jhrvo0/ChickenLittle/docs/design/redesign_2026-11/prototype.html

MOTIONPET

Dispositivo5 Tema PalcoF Simular

1

# —

—

1. 1Piloto
2. 2Mira
3. 3Força
4. 4Voo
5. 5Resultado

PINTINHO · nível 3120 XP

$42 moedas

Que dia bom!

Ovo Pintinho Galo cyber

## Piu-piu

Feliz

Saciedade—

Felicidade—

Energia—

Saúde—

## Cuidar

Alimentarou cartão no IR Carinhoou mão perto Brincar Descansar Cuidar da saúde

Salvar Carregar

RECORDE—

Recorde —

$42 moedas

## ATÉ ONDE O PIU-PIU VOA?

1. 1mãomira o ângulo
2. 2cartãosegura para dar força
3. 3solta na faixa verde e voa!

Aproxime e afaste o cartão do IR para jogar

Piloto de hoje

## PIU-PIU

Pintinho · nível 3Energia 85% · pronto

Passe o cartão de novo para ir à rampa

Ângulo

—

mão a —

pertosobe70°

longedesce20°

Pronto? Segure o cartão no IR

Força

—

FAIXA PERFEITA

050%100%

tire o cartão para lançar

Distância

0,0 m

altura 0,0 m

NOVO RECORDE!

Distância do voo

—

—

—pontos

—moedas

—XP

—quiques

Passe o cartão para jogar de novo

## Loja

$42

Sem a placa? Use o teclado

JogarEnter Carregar forçaEspaço Ângulo +↑ Ângulo −↓ VoltarB

Ativar somM

Nota de agora

—

—

♪♫

## Som

desligado

Ativar somM

O navegador só libera o áudio depois de um clique.

Volume 35%

## Como tocar

- pertonotas graves
- longenotas agudas
- cartãosilêncio: não

Faixa das notas: de 8 a 48 cm do sensor.

01 · Olá, mundo

## —

—

MOTIONPET

1 / 8

## Slide

1 / 8

Anterior Próximo

Pronto.

## Gestos

- pertopróximo
- longeanterior
- cartãopróximo

Espere 1 segundo entre um gesto e outro. Teclado: ← →

## Conexão

—

Porta —

Estado —

Última leitura —

Quadros recebidos —

Pacotes RX / TX —

## Ultrassom

HC-SR04 · TRIG GPIO5 · ECHO GPIO34

Distância —

Leitura válida —

## Infravermelho e gesto

TCRT5000 · GPIO35

Cartão no IR —

Gesto do classificador —

—

Os modos usam regras de distância e as bordas do IR; o classificador aparece aqui só para consulta.

## LCD lógico 20×4

substituído pela tela

## Aconteceu por aqui

## Atalhos

1a 5 troca de telaFModo Palco (tela cheia) · Esc saiTtema claro / escuroEnterPet Launch: confirmar / lançarEspaçoPet Launch: carregar força↑↓ ângulo · B voltar←→ slidesMMúsica: ligar / desligar o som

Mão

—cm

distância da mão

O que a mão faz aquiHC-SR04 · TRIG GPIO5 · ECHO GPIO34

0102030405060+

Sem placa: conecte ao lado para ver a mão aqui

Cartão no IR

—

—

TCRT5000 · GPIO35

Desconectado

Escolha a porta e conecte

Conectar

Desconectar

1234 SairEsc

## Simulação (só no protótipo)

Passe o mouse na régua para mover a mão. Segure a lâmpada do IR ou a tecla C para o cartão.

Conexão Fase do Launch Estágio do pet Humor Mão e cartão automáticos
