jhrvo0/ChickenLittle/applications/README.md

# Aplicações

Este é um ponto de entrada para a estrutura indicada na especificação acadêmica. As fontes continuam nos diretórios existentes para preservar imports, scripts e testes:

- [Aplicação local, frontend e backend](../terminal/)
- [Machine learning e API de inferência](../ml/)
- [Simulador](../simulator/)
- [Infraestrutura de experimentos](../ops/)

Consulte o [README principal](../README.md) e o [índice de documentação](../docs/README.md). A aceitação de índices como organização por diretório deve ser confirmada com os professores.
