jhrvo0/ChickenLittle/docs/academico/checkpoint_2026-11-12/figuras/figura-1-circuito-atual.png

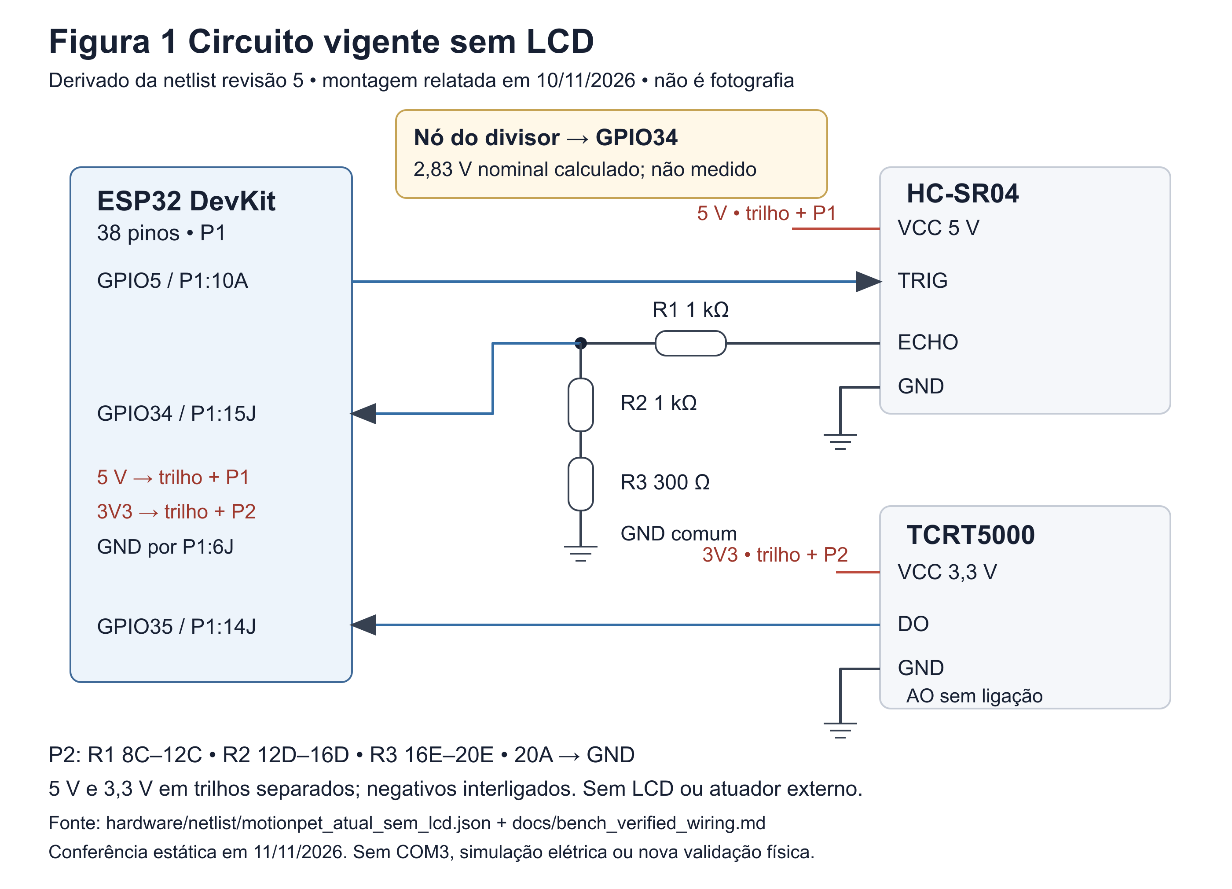
docs/academico/checkpoint_2026-11-12/figuras/figura-1-circuito-atual.png
