jhrvo0/ChickenLittle/docs/academico/checkpoint_2026-11-12/figuras/figura-3-arquitetura.png

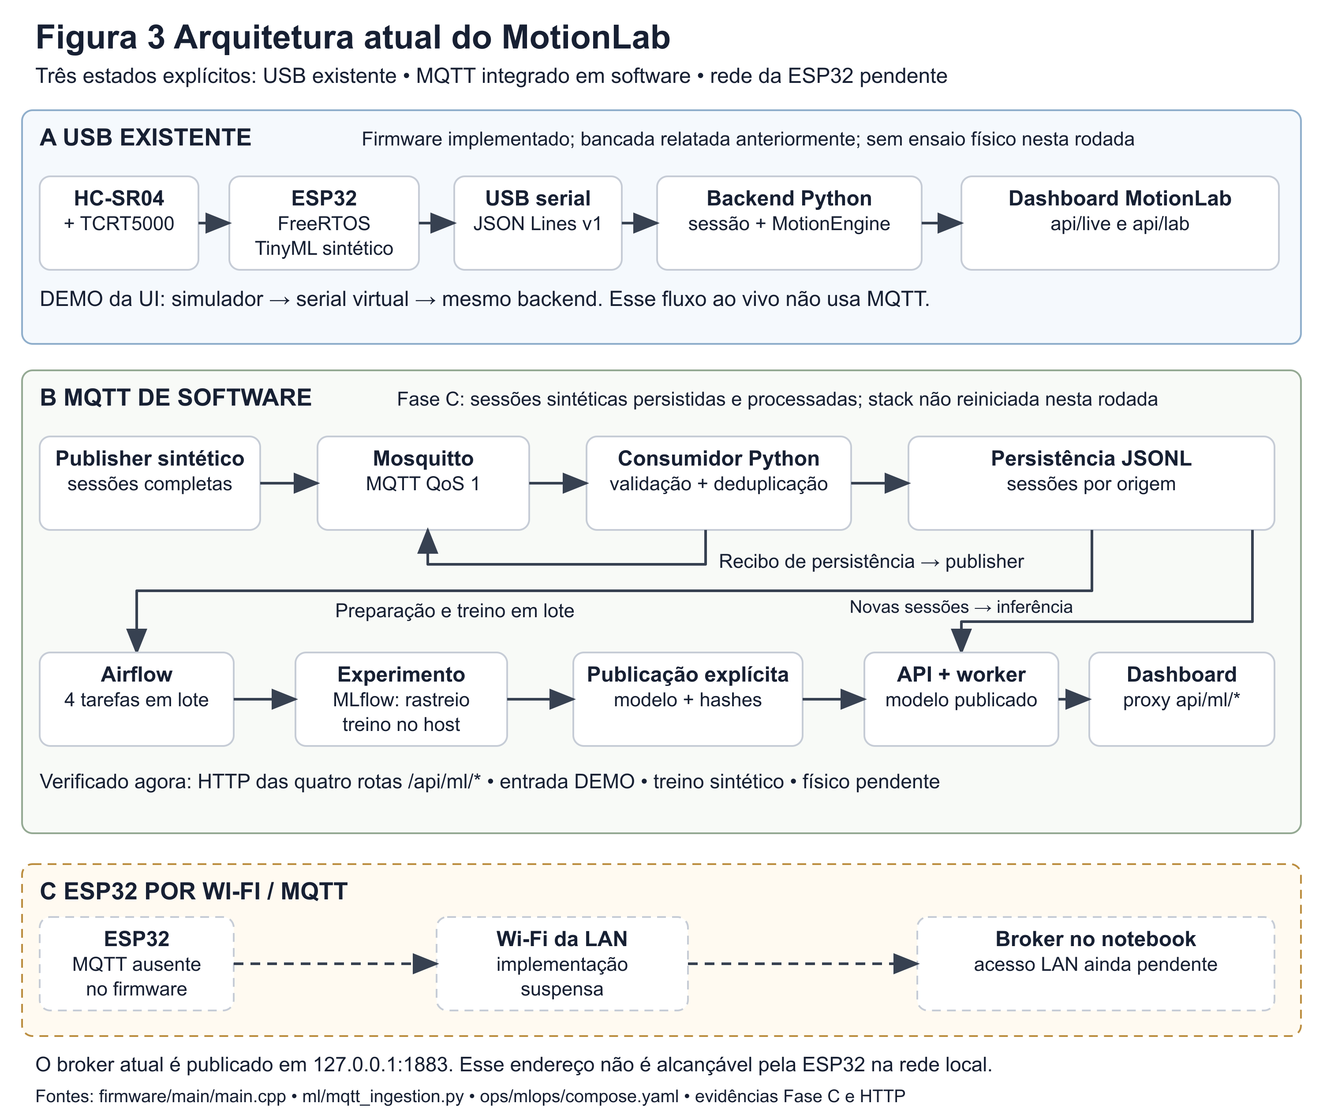
docs/academico/checkpoint_2026-11-12/figuras/figura-3-arquitetura.png
