jhrvo0/ChickenLittle/docs/capturas-motionlab/01-inicio-demo.jpg

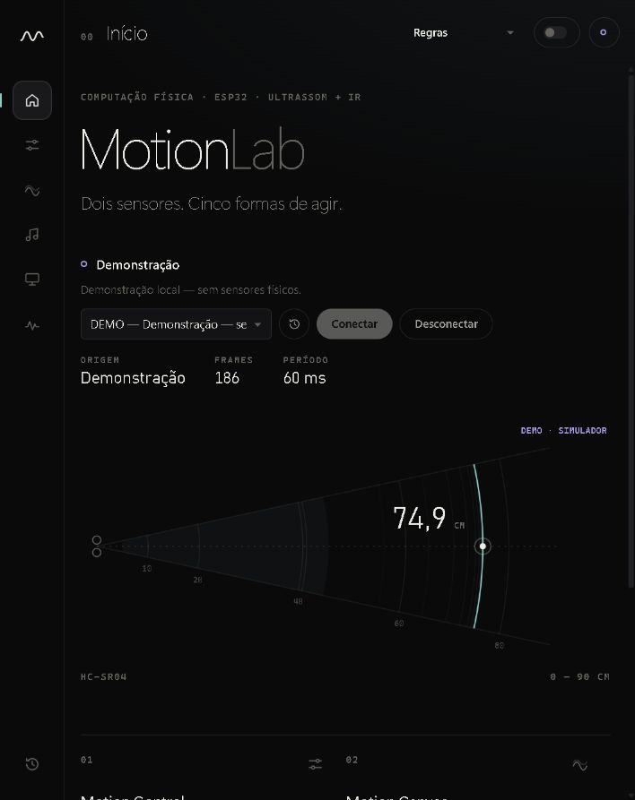
docs/capturas-motionlab/01-inicio-demo.jpg
