jhrvo0/ChickenLittle/docs/fotos-bancada/detalhe-divisor.jpg

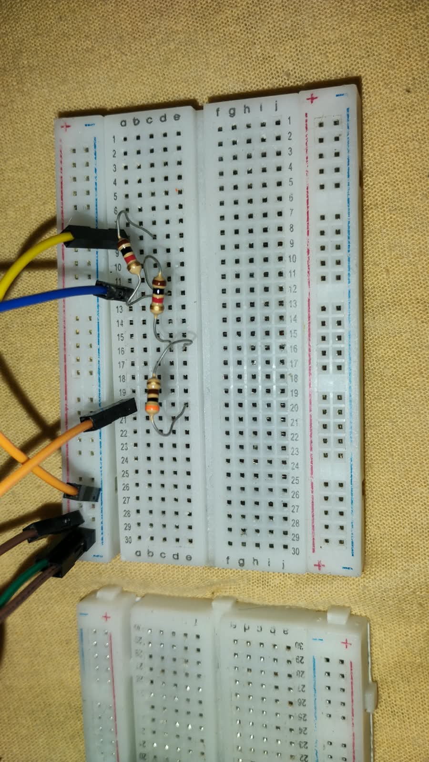
docs/fotos-bancada/detalhe-divisor.jpg
