jhrvo0/ChickenLittle/docs/fotos-bancada/detalhe-esp32.jpg

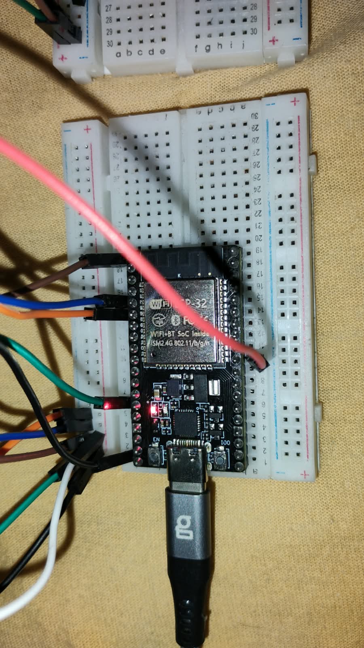
docs/fotos-bancada/detalhe-esp32.jpg
