jhrvo0/ChickenLittle/hardware/out/esquematico_estagioA.png

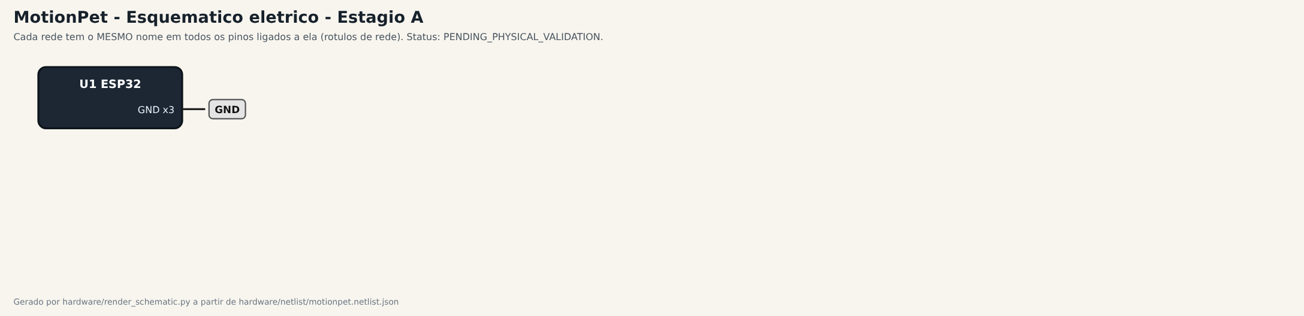
hardware/out/esquematico_estagioA.png
