jhrvo0/ChickenLittle/hardware/out/esquematico_estagioB.png

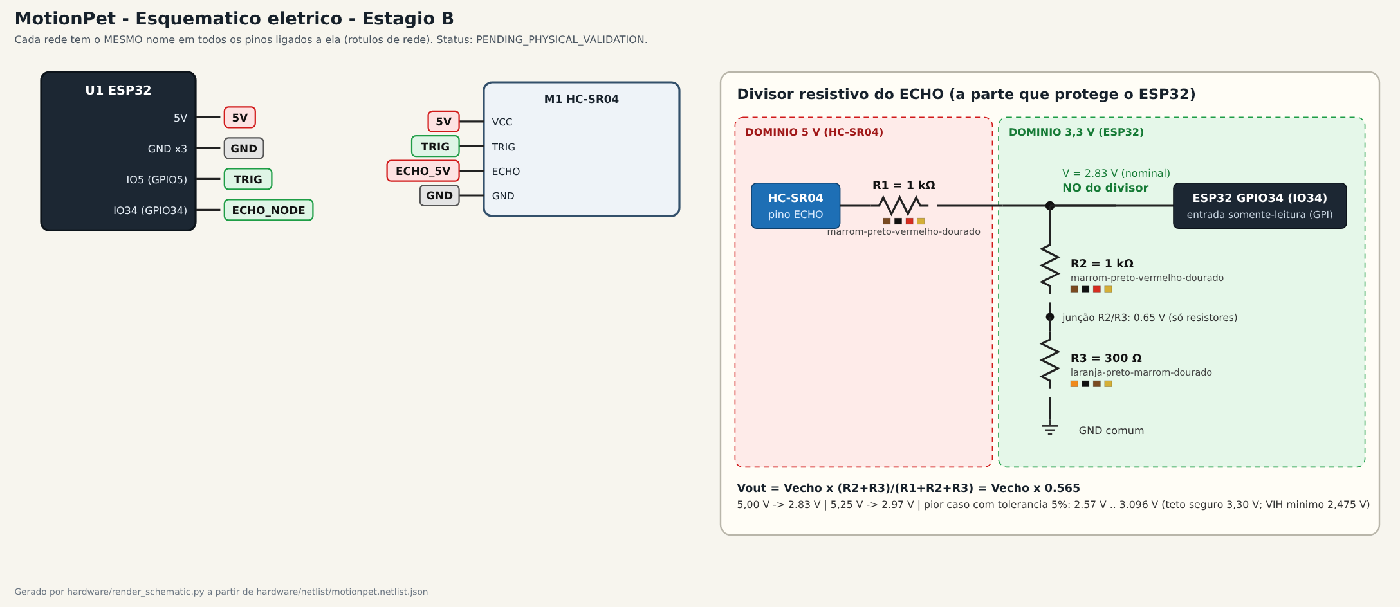
hardware/out/esquematico_estagioB.png
