jhrvo0/ChickenLittle/hardware/out/esquematico_estagioC.png

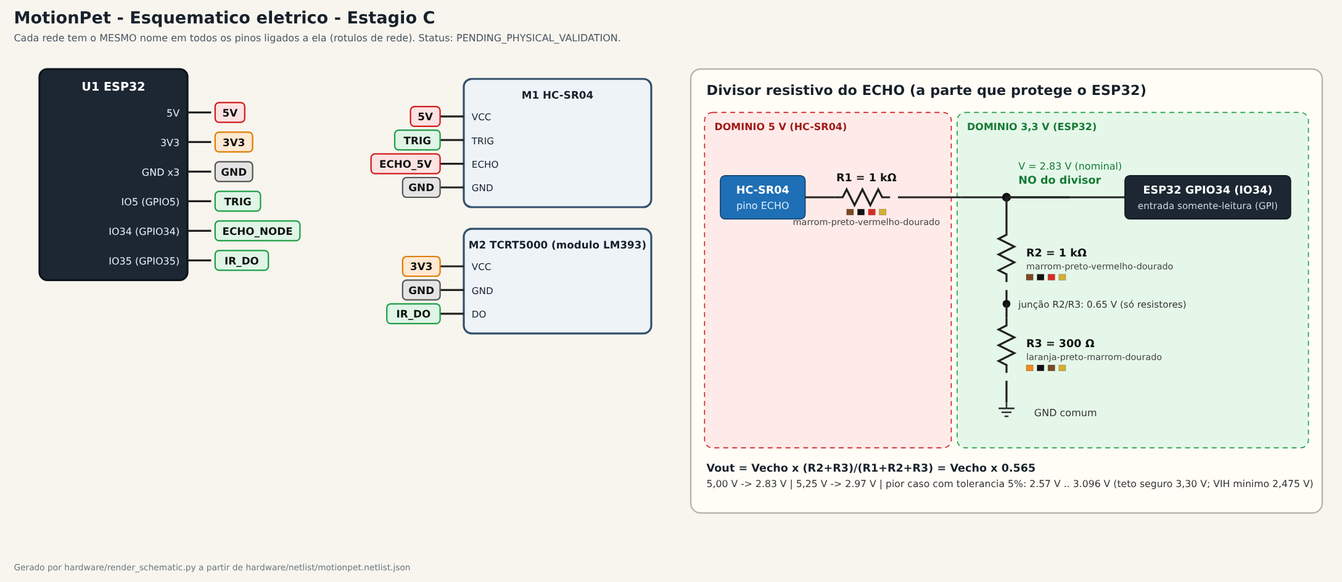
hardware/out/esquematico_estagioC.png
