jhrvo0/ChickenLittle/hardware/out/esquematico_estagioD.png

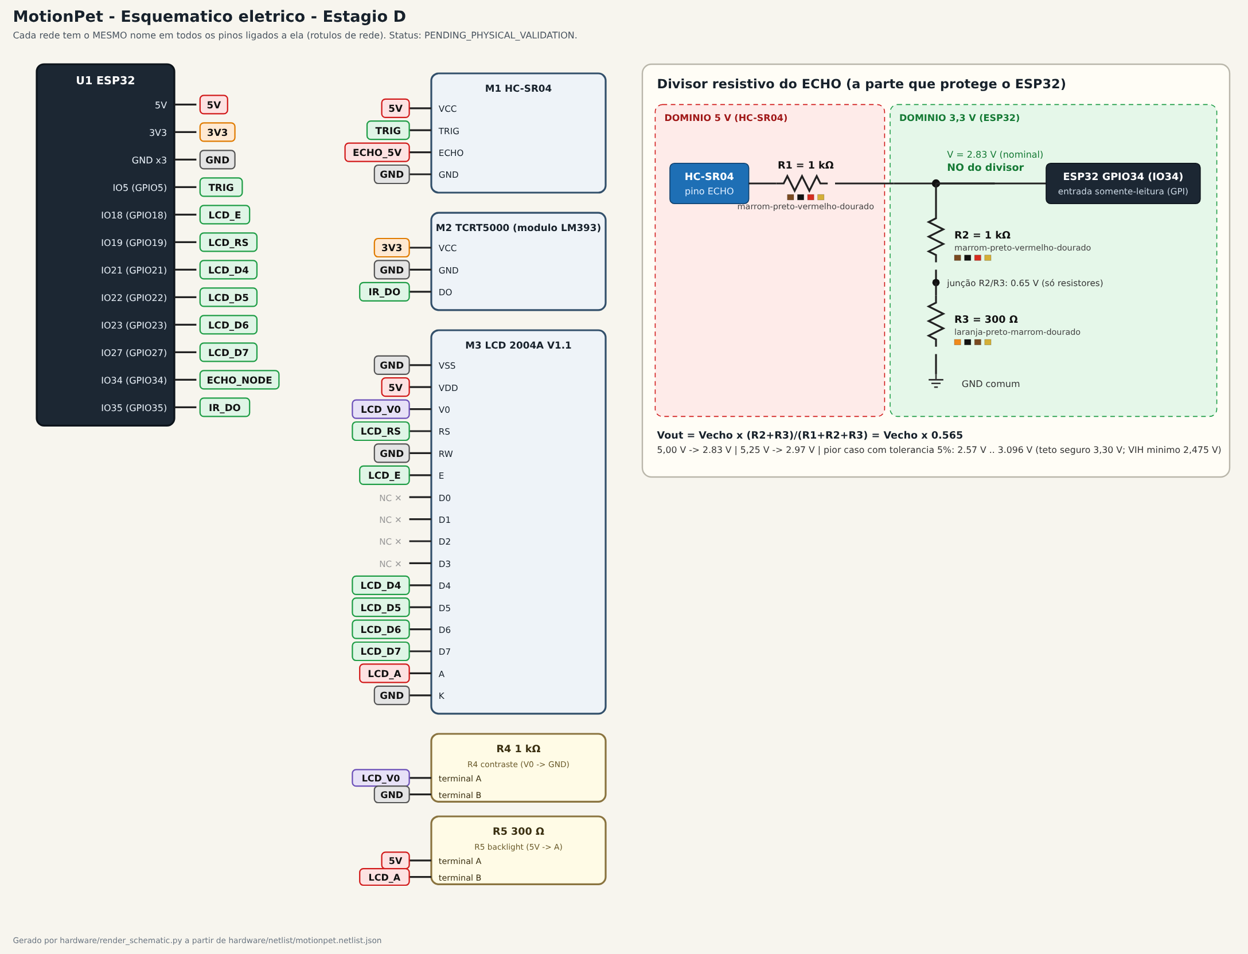
hardware/out/esquematico_estagioD.png
