jhrvo0/ChickenLittle/hardware/out/protoboard_estagioA.png

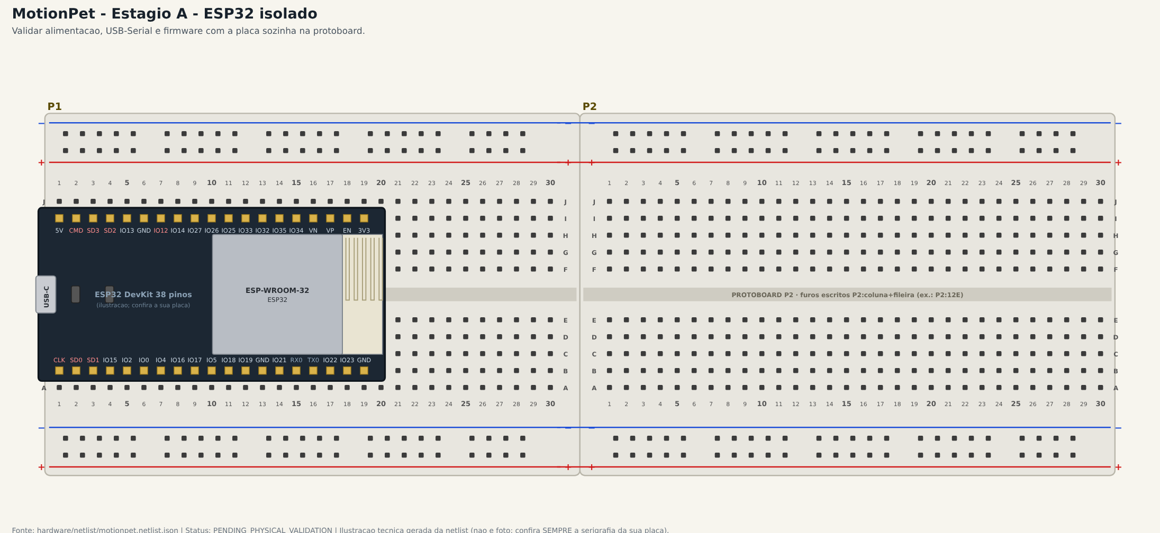
hardware/out/protoboard_estagioA.png
