jhrvo0/ChickenLittle/hardware/out/protoboard_estagioB.png

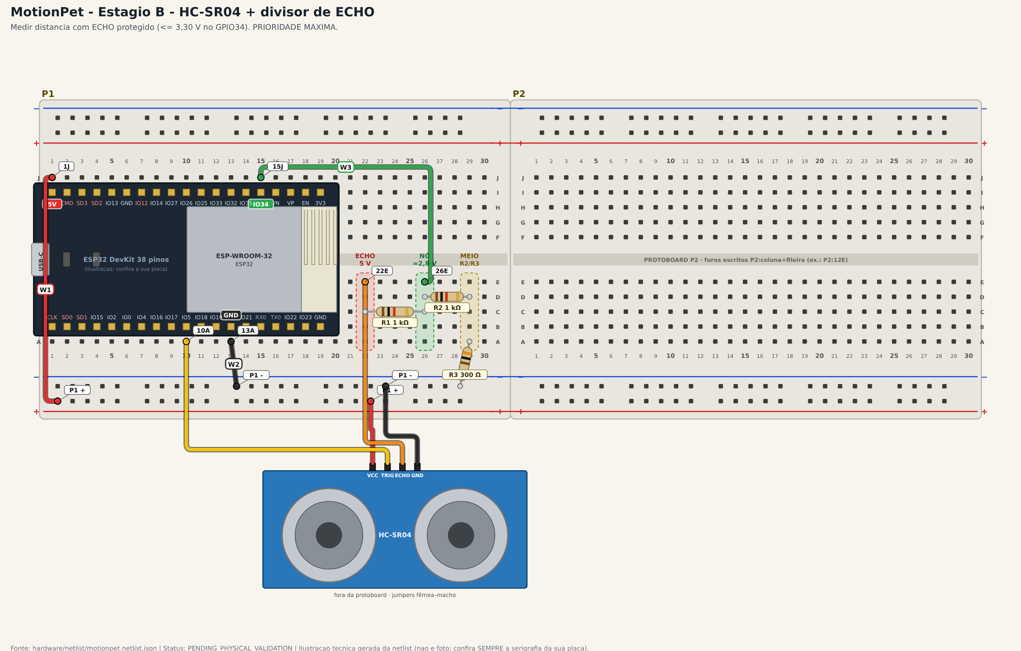
hardware/out/protoboard_estagioB.png
