jhrvo0/ChickenLittle/hardware/out/protoboard_estagioB_passo5_ensaio_divisor.png

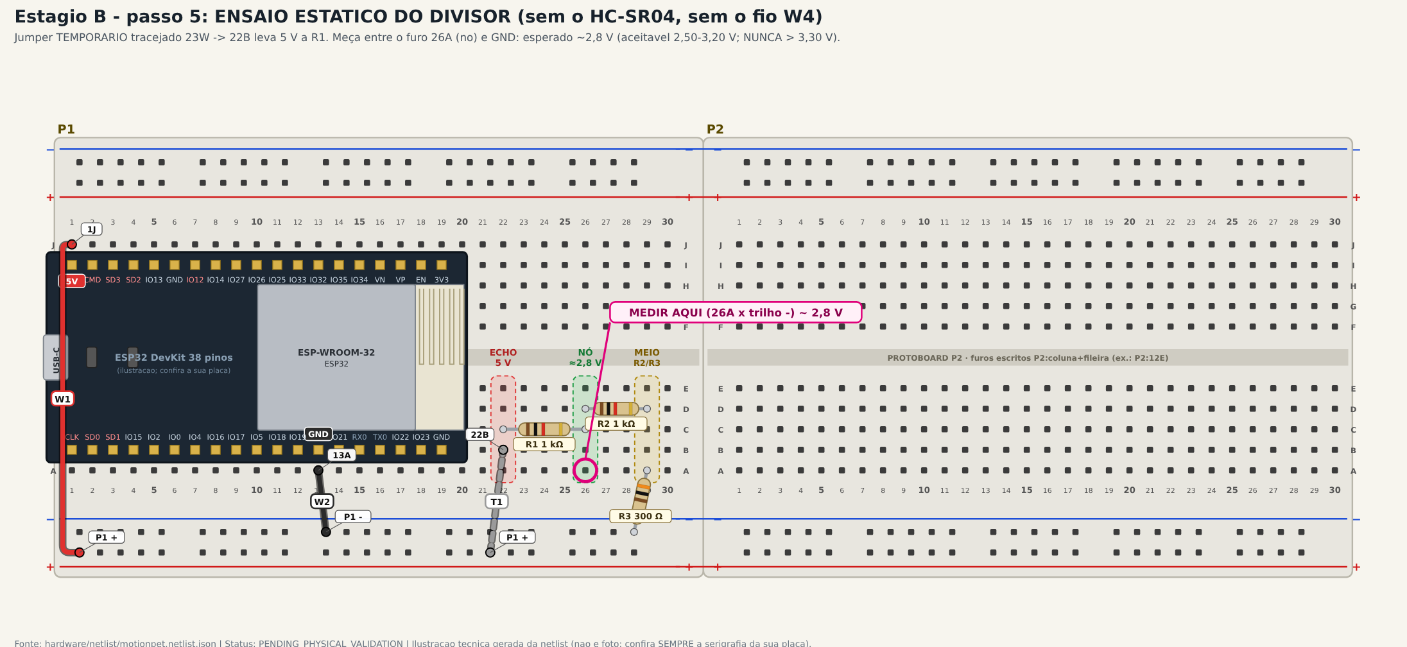
hardware/out/protoboard_estagioB_passo5_ensaio_divisor.png
