jhrvo0/ChickenLittle/hardware/out/protoboard_estagioC.png

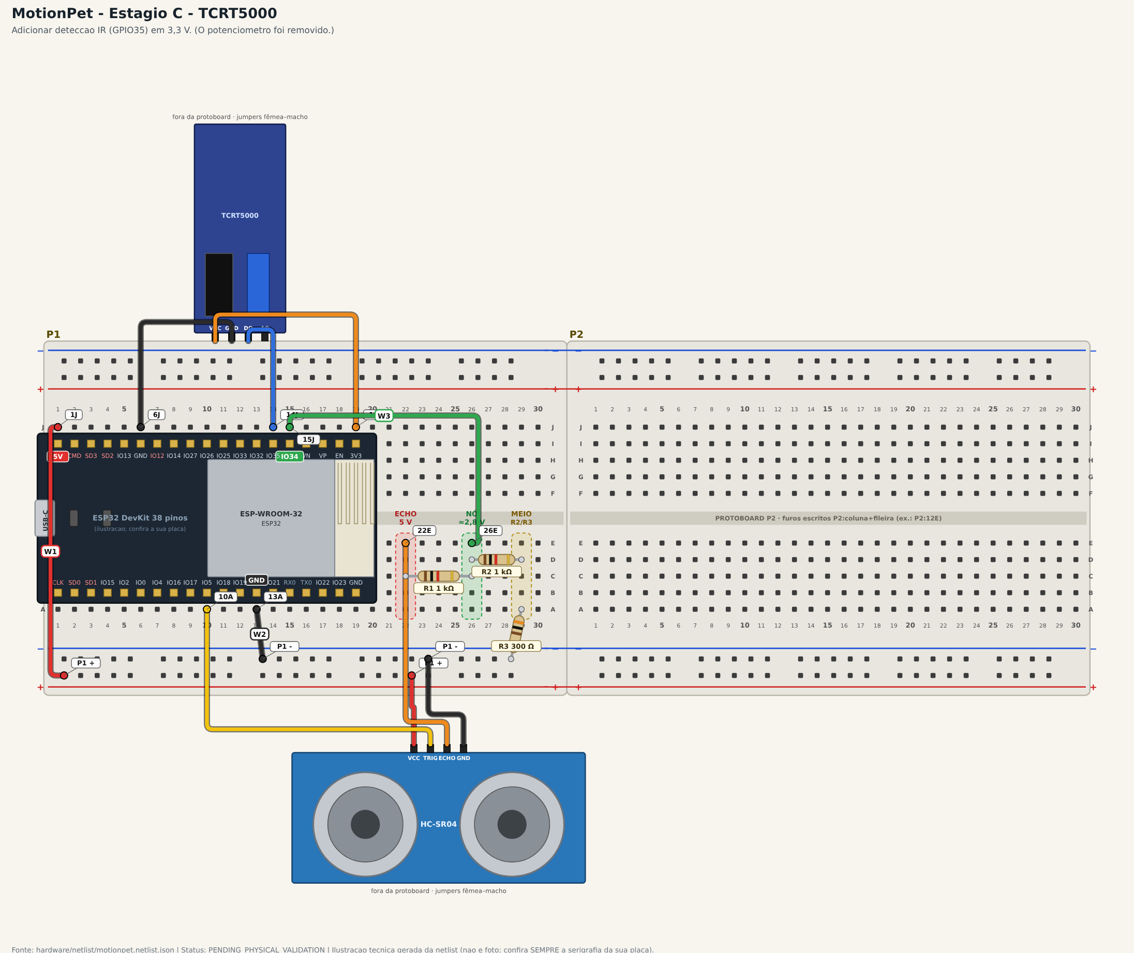
hardware/out/protoboard_estagioC.png
