jhrvo0/ChickenLittle/hardware/out/protoboard_estagioD.png

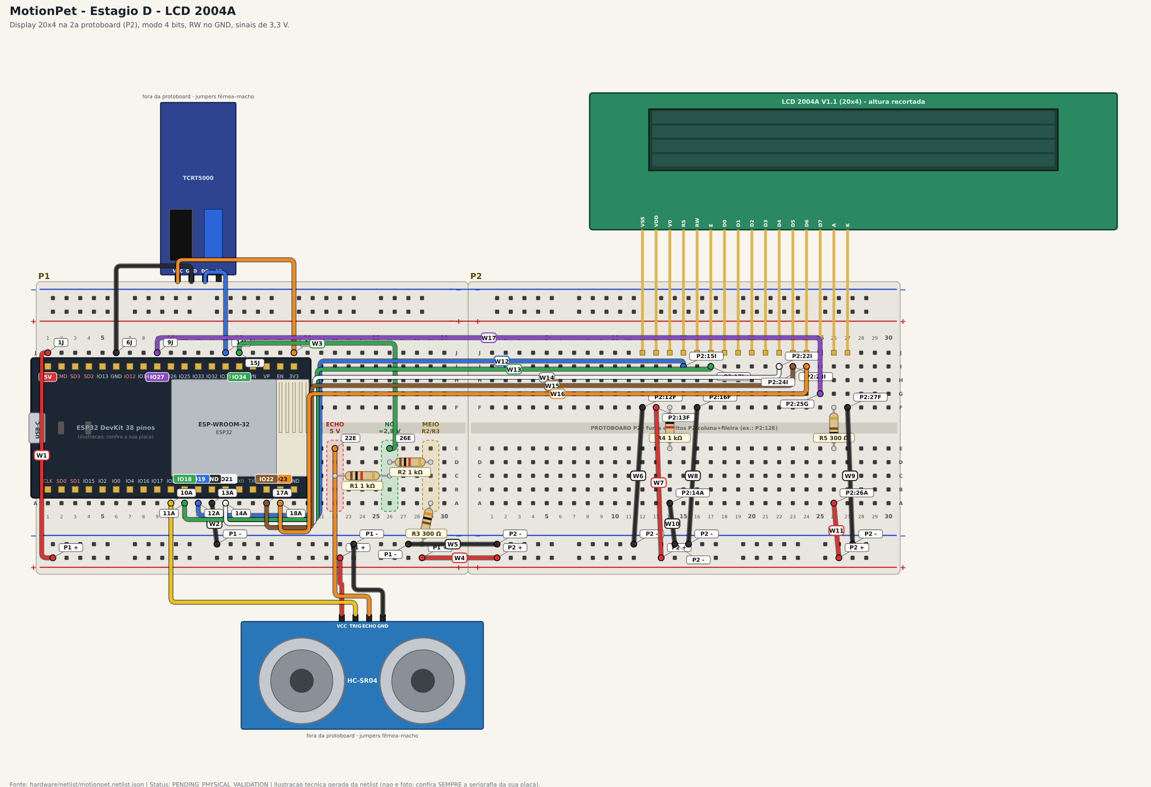
hardware/out/protoboard_estagioD.png
