jhrvo0/ChickenLittle/hardware/guia_montagem_final.html

MotionPet · montagem com testesRevisão 4 · GND em 6J · diagnóstico sem desmontar os trilhos

Mostrar todos os fiosAmpliar desenho

P1: + = 5 V · P2: + = 3,3 V · ambos − = GND.
Use o primeiro grupo de cinco furos do par junto à fileira J. O outro par lateral fica livre. Os números +1/−1 etc. identificam contatos desse grupo no guia.

← e → navegam. O fio do passo atual fica destacado. A posição dos conectores dos módulos é ilustrativa; confira os nomes impressos.

Ative os botões de teste
Na pasta do projeto, rode:

.\.venv\Scripts\python.exe -m terminal.bench.guide

Depois abra o guia com testes locais (http://127.0.0.1:8766/). A versão aberta como arquivo continua mostrando todos os passos.

Porta USB:Atualizar portas

Tensão medida no 3V3 / VCC do módulo (V)
Tensão anotada no ensaio estático do divisor (V)

Medição com jumper de 5 V, sem HC-SR04 e sem GPIO34; não é o pico de ECHO. Distância medida entre o alvo e o HC-SR04 (cm)
Conferi a fiação deste componente com a USB desligada. Comparei o LCD físico com o quadro recebido e a imagem está correta. Executar teste

Ver dados recebidos pela serial

Instale cada componente com USB fora. Conecte para testar; se alterar fios depois, repita o teste. Sem medições ou confirmação visual, o resultado pode ficar pendente.

Luz do LCD instável ou apagada: ver diagnóstico

## Diagnóstico temporário de iluminação

USB fora para mudar os fios. Este teste usa 5 V somente no LCD, com os cabos SDA/SCL removidos. Não é a montagem final. Não execute o teste I²C neste modo.

Conserve a alimentação já montada. Não coloque outra ponta nos furos 1J, 6J ou 19J: eles já alimentam os trilhos.

Fio | Origem | Destino | Ação
F1 | P1:1J | P1:+1 | Fica no lugar
F2 | P1:6J | P1:-1 | Fica no lugar
F3 | P1:19J | P2:+1 | Fica no lugar
F4 | P1:-2 | P2:-1 | Fica no lugar

Retire os cabos F16 (SDA) e F17 (SCL) por inteiro, antes de usar 5 V. Depois mova somente as pontas macho destes dois cabos, mantendo as pontas do LCD nos mesmos pinos:

Cabo do LCD | Sai de | Vai para
F14 · LCD.VCC | P2:+3 | P1:+3
F15 · LCD.GND | P2:-3 | P1:-4

P1:+3 e P1:−4 são contatos livres do mesmo grupo usado por F1/F2. Não pode haver jumper temporário de ensaio nesses contatos. Os demais fios e resistores já posicionados ficam como estão; não adicione novos componentes durante este diagnóstico.

Conecte USB apenas para observar: a luz POWER fica estável? A iluminação frontal acende? A página não verifica essas luzes automaticamente. Sem SDA/SCL, não estamos esperando texto.

## Voltar à montagem normal de 3,3 V

Desligue USB e devolva primeiro a alimentação:

Fio | Sai de | Volta para
F14 | P1:+3 | P2:+3
F15 | P1:-4 | P2:-3

Só depois recoloque F16 (SDA → P1:14A) e F17 (SCL → P1:17A). Se o painel só funcionar em 5 V, a comunicação exige conversor I²C; não reconecte os sinais diretos mantendo 5 V.

Com USB fora, devolvi F14 a P2:+3 e F15 a P2:−3 antes de recolocar SDA/SCL.Voltar ao teste LCD em 3,3 V

← VoltarPróximo →

Guia escrito e alternativas · Referências elétricas

## Lista completa da montagem normal · LCD em 3,3 V

P1 e P2 são placas diferentes. No diagnóstico de iluminação, siga as mudanças temporárias e a restauração mostradas no painel acima. Furos da ESP32 válidos para o perfil de 38 pinos na posição mostrada. O +1 de cada placa é o primeiro furo do grupo de cinco escolhido no trilho +; −1 idem no trilho −. Nenhum furo recebe duas pontas.

Item | Ligação | Origem | Destino
R1 | 1000 Ω · só no ECHO | P2:8C | P2:12C
R2 | 1000 Ω · só no ECHO | P2:12D | P2:16D
R3 | 300 Ω · só no ECHO | P2:16E | P2:20E
F1 | ESP32.5V → Trilho +5V P1 | P1:1J | P1:+1
F2 | ESP32.GND@J2.14 → Trilho GND P1 | P1:6J | P1:-1
F3 | ESP32.3V3 → Trilho +3V3 P2 | P1:19J | P2:+1
F4 | Trilho GND P1 → Trilho GND P2 | P1:-2 | P2:-1
F5 | HC-SR04.VCC → Trilho +5V P1 | pino do módulo | P1:+2
F6 | HC-SR04.GND → Trilho GND P1 | pino do módulo | P1:-3
F7 | HC-SR04.TRIG → ESP32.IO5 | pino do módulo | P1:10A
F8 | HC-SR04.ECHO → Entrada R1 | pino do módulo | P2:8A
F9 | No protegido → ESP32.IO34 | P2:12A | P1:15J
F10 | Base R3 → Trilho GND P2 | P2:20A | P2:-4
F11 | TCRT5000.VCC → Trilho +3V3 P2 | pino do módulo | P2:+2
F12 | TCRT5000.GND → Trilho GND P2 | pino do módulo | P2:-2
F13 | TCRT5000.DO → ESP32.IO35 | pino do módulo | P1:14J
F14 | LCD.VCC → Trilho +3V3 P2 | pino do módulo | P2:+3
F15 | LCD.GND → Trilho GND P2 | pino do módulo | P2:-3
F16 | LCD.SDA → ESP32.IO21 | pino do módulo | P1:14A
F17 | LCD.SCL → ESP32.IO22 | pino do módulo | P1:17A
