jhrvo0/ChickenLittle/hardware/out/montagem_final_i2c.png

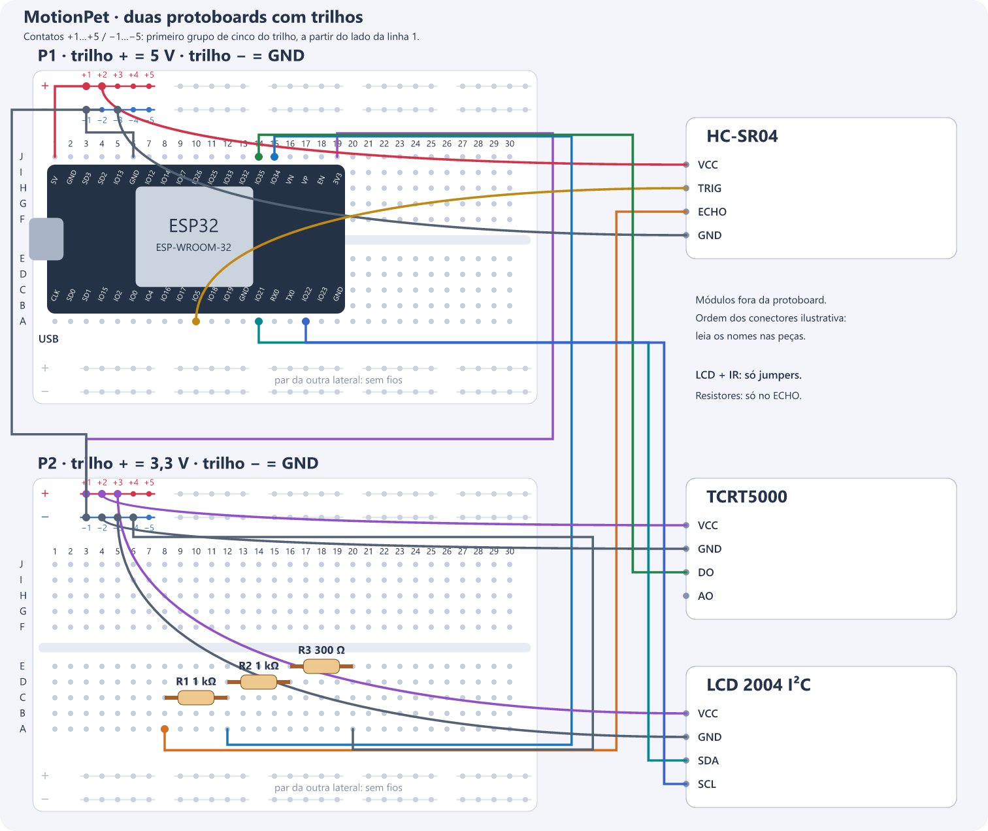
hardware/out/montagem_final_i2c.png
