jhrvo0/ChickenLittle/teste-hcsr04/resultados_20261105_104127_brutas.txt

[ref=10] Distancia: 14.6 cm
[ref=10] Distancia: 14.1 cm
[ref=10] Distancia: 14.1 cm
[ref=10] Distancia: 14.8 cm
[ref=10] Distancia: 14.7 cm
[ref=10] Distancia: 14.4 cm
[ref=10] Distancia: 16.6 cm
[ref=10] Distancia: 14.9 cm
[ref=10] Distancia: 15.7 cm
[ref=10] Distancia: 16.0 cm
[ref=10] Distancia: 14.5 cm
[ref=10] Distancia: 17.0 cm
[ref=10] SEM ECO
[ref=10] Distancia: 16.3 cm
[ref=10] Distancia: 14.7 cm
[ref=10] Distancia: 14.5 cm
[ref=10] Distancia: 16.3 cm
[ref=10] Distancia: 16.1 cm
[ref=10] Distancia: 14.4 cm
[ref=10] Distancia: 15.3 cm
[ref=10] Distancia: 14.0 cm
[ref=10] Distancia: 49.0 cm
[ref=10] Distancia: 45.4 cm
[ref=10] Distancia: 42.6 cm
[ref=10] Distancia: 47.0 cm
[ref=10] Distancia: 43.9 cm
[ref=10] Distancia: 39.4 cm
[ref=10] Distancia: 39.5 cm
[ref=10] Distancia: 40.4 cm
[ref=10] Distancia: 43.8 cm
[ref=25] Distancia: 41.1 cm
[ref=25] Distancia: 41.2 cm
[ref=25] Distancia: 44.6 cm
[ref=25] Distancia: 42.9 cm
[ref=25] Distancia: 50.5 cm
[ref=25] Distancia: 39.8 cm
[ref=25] SEM ECO
[ref=25] Distancia: 41.3 cm
[ref=25] Distancia: 42.0 cm
[ref=25] Distancia: 42.8 cm
[ref=25] SEM ECO
[ref=25] SEM ECO
[ref=25] Distancia: 42.4 cm
[ref=25] Distancia: 46.5 cm
[ref=25] Distancia: 50.8 cm
[ref=25] Distancia: 46.4 cm
[ref=25] Distancia: 45.4 cm
[ref=25] Distancia: 48.0 cm
[ref=25] Distancia: 48.8 cm
[ref=25] Distancia: 44.9 cm
[ref=25] Distancia: 45.5 cm
[ref=25] Distancia: 48.4 cm
[ref=25] Distancia: 47.6 cm
[ref=25] Distancia: 48.9 cm
[ref=25] Distancia: 45.9 cm
[ref=25] Distancia: 46.8 cm
[ref=25] Distancia: 48.1 cm
[ref=25] Distancia: 48.0 cm
[ref=25] Distancia: 37.9 cm
[ref=25] Distancia: 54.8 cm
[ref=50] Distancia: 36.9 cm
[ref=50] SEM ECO
[ref=50] Distancia: 35.9 cm
[ref=50] Distancia: 35.5 cm
[ref=50] Distancia: 36.0 cm
[ref=50] Distancia: 44.4 cm
[ref=50] Distancia: 46.0 cm
[ref=50] Distancia: 46.9 cm
[ref=50] Distancia: 46.9 cm
[ref=50] Distancia: 48.5 cm
[ref=50] Distancia: 48.8 cm
[ref=50] Distancia: 48.3 cm
[ref=50] Distancia: 47.2 cm
[ref=50] Distancia: 48.8 cm
[ref=50] Distancia: 46.3 cm
[ref=50] Distancia: 48.0 cm
[ref=50] Distancia: 48.4 cm
[ref=50] Distancia: 49.5 cm
[ref=50] Distancia: 47.1 cm
[ref=50] Distancia: 42.2 cm
[ref=50] SEM ECO
[ref=50] SEM ECO
[ref=50] Distancia: 40.6 cm
[ref=50] Distancia: 40.5 cm
[ref=50] Distancia: 41.5 cm
[ref=50] Distancia: 45.4 cm
[ref=50] Distancia: 44.9 cm
[ref=50] Distancia: 38.7 cm
[ref=50] SEM ECO
[ref=50] Distancia: 36.8 cm
[ref=100] Distancia: 45.3 cm
[ref=100] Distancia: 45.7 cm
[ref=100] Distancia: 47.3 cm
[ref=100] Distancia: 46.9 cm
[ref=100] Distancia: 45.3 cm
[ref=100] Distancia: 45.5 cm
[ref=100] Distancia: 49.3 cm
[ref=100] Distancia: 46.8 cm
[ref=100] Distancia: 44.2 cm
[ref=100] Distancia: 44.8 cm
[ref=100] Distancia: 45.0 cm
[ref=100] Distancia: 43.8 cm
[ref=100] Distancia: 48.1 cm
[ref=100] Distancia: 46.6 cm
[ref=100] SEM ECO
[ref=100] Distancia: 43.4 cm
[ref=100] Distancia: 43.0 cm
[ref=100] Distancia: 46.3 cm
[ref=100] Distancia: 46.8 cm
[ref=100] Distancia: 50.3 cm
[ref=100] Distancia: 48.4 cm
[ref=100] Distancia: 50.4 cm
[ref=100] Distancia: 47.7 cm
[ref=100] Distancia: 45.4 cm
[ref=100] Distancia: 47.6 cm
[ref=100] Distancia: 47.7 cm
[ref=100] Distancia: 49.4 cm
[ref=100] Distancia: 13.2 cm
[ref=100] Distancia: 13.6 cm
[ref=100] Distancia: 15.8 cm
