jhrvo0/ChickenLittle/teste-hcsr04/resultados_20261105_104405_brutas.txt

[ref=10] Distancia: 14.1 cm
[ref=10] Distancia: 14.8 cm
[ref=10] Distancia: 15.3 cm
[ref=10] Distancia: 15.0 cm
[ref=10] Distancia: 15.1 cm
[ref=10] Distancia: 15.4 cm
[ref=10] Distancia: 17.7 cm
[ref=10] Distancia: 15.7 cm
[ref=10] Distancia: 16.8 cm
[ref=10] Distancia: 16.8 cm
[ref=10] Distancia: 14.6 cm
[ref=10] Distancia: 14.7 cm
[ref=10] Distancia: 14.5 cm
[ref=10] Distancia: 15.0 cm
[ref=10] Distancia: 17.4 cm
[ref=10] Distancia: 15.5 cm
[ref=10] Distancia: 14.1 cm
[ref=10] Distancia: 14.4 cm
[ref=10] Distancia: 16.1 cm
[ref=10] Distancia: 14.4 cm
[ref=10] Distancia: 14.8 cm
[ref=10] Distancia: 15.1 cm
[ref=10] Distancia: 14.7 cm
[ref=10] Distancia: 15.8 cm
[ref=10] Distancia: 17.6 cm
[ref=10] Distancia: 16.6 cm
[ref=10] Distancia: 20.6 cm
[ref=10] Distancia: 16.7 cm
[ref=10] Distancia: 15.2 cm
[ref=10] Distancia: 14.8 cm
[ref=25] Distancia: 18.6 cm
[ref=25] Distancia: 18.5 cm
[ref=25] Distancia: 59.4 cm
[ref=25] Distancia: 19.3 cm
[ref=25] Distancia: 18.4 cm
[ref=25] Distancia: 18.7 cm
[ref=25] Distancia: 18.4 cm
[ref=25] Distancia: 18.0 cm
[ref=25] Distancia: 18.4 cm
[ref=25] Distancia: 18.1 cm
[ref=25] Distancia: 17.8 cm
[ref=25] Distancia: 18.4 cm
[ref=25] Distancia: 18.4 cm
[ref=25] Distancia: 18.8 cm
[ref=25] Distancia: 18.5 cm
[ref=25] Distancia: 19.1 cm
[ref=25] SEM ECO
[ref=25] Distancia: 19.5 cm
[ref=25] Distancia: 18.6 cm
[ref=25] Distancia: 18.7 cm
[ref=25] Distancia: 18.7 cm
[ref=25] Distancia: 19.1 cm
[ref=25] Distancia: 20.5 cm
[ref=25] Distancia: 20.1 cm
[ref=25] Distancia: 20.2 cm
[ref=25] Distancia: 20.2 cm
[ref=25] Distancia: 20.9 cm
[ref=25] Distancia: 22.3 cm
[ref=25] Distancia: 18.7 cm
[ref=25] Distancia: 18.2 cm
[ref=50] Distancia: 65.0 cm
[ref=50] Distancia: 57.3 cm
[ref=50] Distancia: 52.5 cm
[ref=50] Distancia: 47.8 cm
[ref=50] Distancia: 50.4 cm
[ref=50] Distancia: 59.0 cm
[ref=50] Distancia: 56.5 cm
[ref=50] Distancia: 61.1 cm
[ref=50] Distancia: 57.1 cm
[ref=50] Distancia: 56.1 cm
[ref=50] Distancia: 56.0 cm
[ref=50] Distancia: 61.7 cm
[ref=50] Distancia: 56.6 cm
[ref=50] Distancia: 54.3 cm
[ref=50] Distancia: 55.2 cm
[ref=50] Distancia: 54.9 cm
[ref=50] Distancia: 53.3 cm
[ref=50] Distancia: 54.5 cm
[ref=50] Distancia: 56.0 cm
[ref=50] Distancia: 54.6 cm
[ref=50] Distancia: 57.9 cm
[ref=50] Distancia: 55.8 cm
[ref=50] Distancia: 52.1 cm
[ref=50] Distancia: 50.9 cm
[ref=50] Distancia: 55.6 cm
[ref=50] Distancia: 53.9 cm
[ref=50] Distancia: 59.1 cm
[ref=50] Distancia: 56.5 cm
[ref=50] Distancia: 57.0 cm
[ref=50] Distancia: 62.3 cm
[ref=100] SEM ECO
[ref=100] SEM ECO
[ref=100] SEM ECO
[ref=100] SEM ECO
[ref=100] SEM ECO
[ref=100] SEM ECO
[ref=100] SEM ECO
[ref=100] SEM ECO
[ref=100] SEM ECO
[ref=100] SEM ECO
[ref=100] SEM ECO
[ref=100] SEM ECO
[ref=100] SEM ECO
[ref=100] SEM ECO
[ref=100] SEM ECO
[ref=100] SEM ECO
[ref=100] SEM ECO
[ref=100] SEM ECO
[ref=100] SEM ECO
[ref=100] SEM ECO
[ref=100] SEM ECO
[ref=100] SEM ECO
[ref=100] SEM ECO
[ref=100] SEM ECO
[ref=100] SEM ECO
[ref=100] SEM ECO
[ref=100] SEM ECO
[ref=100] SEM ECO
[ref=100] SEM ECO
[ref=100] SEM ECO
