jhrvo0/ChickenLittle/teste-hcsr04/resultados_20261105_104127.csv

data | config | ref_cm | tentativas | validas | falhas | taxa_validas_pct | mediana_cm | media_cm | desvio_cm | min_cm | max_cm | erro_cm | erro_pct | encerrou_por_tempo
2026-11-05T10:42:05 | VCC 3V3, ECHO direto ao GPIO34, sem divisor | 10 | 30 | 29 | 1 | 96.7 | 16.0 | 23.93 | 13.46 | 14.0 | 49.0 | 6.0 | 60.0 | False
2026-11-05T10:42:20 | VCC 3V3, ECHO direto ao GPIO34, sem divisor | 25 | 30 | 27 | 3 | 90.0 | 45.9 | 45.6 | 3.82 | 37.9 | 54.8 | 20.9 | 83.6 | False
2026-11-05T10:42:35 | VCC 3V3, ECHO direto ao GPIO34, sem divisor | 50 | 30 | 26 | 4 | 86.7 | 45.7 | 43.85 | 4.75 | 35.5 | 49.5 | -4.3 | -8.6 | False
2026-11-05T10:42:50 | VCC 3V3, ECHO direto ao GPIO34, sem divisor | 100 | 30 | 29 | 1 | 96.7 | 46.3 | 43.23 | 10.22 | 13.2 | 50.4 | -53.7 | -53.7 | False
