jhrvo0/ChickenLittle/(list of files, drawings)

Other design files:
hardware/out/MotionPet_estagioA.fzz
hardware/out/MotionPet_estagioB.fzz
hardware/out/MotionPet_estagioC.fzz
hardware/out/MotionPet_estagioD.fzz
hardware/out/MotionPet_estagioE.fzz
