jhrvo0/ChickenLittle/(commit log)

2026-10-29 feat(cycle-3): implement ESP32 FreeRTOS firmware, TinyML inference, NVS, LCD 2004A and bench guide
2026-10-29 feat(cad): netlist canonica e montagem em protoboard (Estagio B) — Ciclo 5 segue PENDING_PHYSICAL_VALIDATION
    - hardware/netlist/motionpet.netlist.json: fonte unica de verdade (componentes, furos, fios, redes, tensoes, confirmacoes C01-C09)
    - model.py: conectividade real da protoboard 830 (conferida contra os 130 barramentos do breadboard2), redes derivadas, validador eletrico
    - geradores deterministas: protoboard/esquematico SVG+PNG, .fzz (Fritzing), Wokwi (diagram.json/wokwi.toml/cenario), tabelas fio a fio e mapa de furos, guia HTML navegavel
    - tests/test_hardware_cad.py: 41 testes (firmware x netlist x protoboard x .fzz x Wokwi + mutacoes que DEVEM reprovar); suite completa 311 passed,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
    [MotionPet_estagioA.fzz, MotionPet_estagioB.fzz, MotionPet_estagioC.fzz, MotionPet_estagioD.fzz, MotionPet_estagioE.fzz, fios_estagioB.csv, fios_estagioC.csv, fios_estagioD.csv]
2026-10-29 feat(cad): guia de montagem refeito como slides (um passo por slide, item novo destacado, zoom)
    - guide_html.py: apresentacao HTML autocontida; 34 slides (intro, materiais, 28 passos A-E, 2 de ajuda); setas/teclado, A = ver tudo, F = tela cheia
    - cada passo declara o que e adicionado (netlist.build_steps.adds); a protoboard cresce na tela, o item novo pisca e o zoom segue a regiao
    - painel "adicione agora": cor do fio, furos das duas pontas com a coluna de referencia, faixas/valores/faixa de medicao dos resistores
    - estagio B: ensaio estatico do divisor como slide de PARADA, com jumper temporario tracejado e ponto de medicao
    - LCD: sinais divididos em 3 slides; potenciometro movido para 34A-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
    [MotionPet_estagioC.fzz, MotionPet_estagioD.fzz, MotionPet_estagioE.fzz, fios_estagioC.csv, fios_estagioD.csv, fios_estagioE.csv, furos_estagioC.csv, furos_estagioD.csv]
2026-10-29 feat(cad): adapta a montagem para meia-protoboard de 30 colunas (A-J x 1-30)
    - modelo parametrizado por perfil de protoboard (data/breadboards.json: bb400 ativo, bb830 mantido); geometria conferida contra os barramentos reais do Fritzing (Half_breadboard_v2)
    - ESP32 em 1-19, HC-SR04 21-24, divisor R1/R2 em 23-27, TCRT5000 21A-24A, potenciometro 28A-30A; estagios A-C validam com 0 erros
    - estagios D (LCD) e E adiados: o LCD nao cabe junto da ESP32 em 30 colunas; layout antigo arquivado em hardware/netlist/archive/
    - guia em slides regenerado (24 slides); saidas obsoletas dos estagios D/E removidas
    - trilhos de alimentacao nao usados; status continua PENDING_PHYSICAL_VALIDATION
    Claude-Session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
    [MotionPet_estagioA.fzz, MotionPet_estagioB.fzz, MotionPet_estagioC.fzz, MotionPet_estagioD.fzz, MotionPet_estagioE.fzz, fios_estagioB.csv, fios_estagioC.csv, fios_estagioD.csv]
2026-10-29 feat(cad): divisor do ECHO com os resistores da bancada (1 kΩ e 300 Ω)
    - R1 = 1 kΩ (23H-27H); R2 = 1 kΩ (27F-30F) em série com R3 = 300 Ω (30G-24G): 2,83 V nominal, pior caso 3,096 V (folga de 204 mV ao teto de 3,30 V), mínimo 2,567 V (acima de VIH)
    - validador soma resistores em série dos ramos do divisor; nova rede DIV_MID; W4 passa a 27I; marcador de medição para cima (27J)
    - guia/esquemático mostram as faixas em português, também lidas a partir da dourada (dourado-vermelho-preto-marrom = 1 kΩ; dourado-marrom-preto-laranja = 300 Ω)
    - testes: valores do usuário, 1k/300 diretos rejeitados (1,15 V e 3,85 V), única combinação em série segura; saídas regeneradas (0 erros,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
    [MotionPet_estagioB.fzz, MotionPet_estagioC.fzz, fios_estagioB.csv, fios_estagioC.csv, furos_estagioB.csv, furos_estagioC.csv]
2026-10-29 feat(cad): LCD 2004A na 2a meia-protoboard (estagios D e E)
    - perfil bb400x2: duas meias-protoboards de 30 colunas encaixadas pela ponta; furos da segunda escritos P2:12E; desenho, Fritzing (duas instancias) e validador com as placas independentes
    - LCD com o conector na fileira A da P2 (VSS em P2:12A ... K em P2:27A); RW/VSS/K no GND por jumpers curtos; R4 1 kΩ (contraste, ajustavel) e R5 300 Ω (backlight); 3 fios de alimentacao e 6 de sinal (GPIO19/18/21/22/23/27)
    - estagios A-C inalterados; guia com 35 slides; Wokwi com LCD em modo 4 bits; testes do estagio D (RW no GND, sinais nos GPIOs do firmware, mutacoes)
    - status continua PENDING_PHYSICAL_VALIDATION
    Claude-Session: https://claude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
    [MotionPet_estagioA.fzz, MotionPet_estagioB.fzz, MotionPet_estagioC.fzz, MotionPet_estagioD.fzz, MotionPet_estagioE.fzz, fios_estagioD.csv, fios_estagioE.csv, furos_estagioD.csv]
2026-10-30 feat(cad): montagem simplificada com trilhos e modulos fora da placa; potenciometro removido
    - trilhos de BAIXO como barramento: + (vermelho) = 5 V do 19A, - (azul) = GND do 14A; P2 recebe por 2 fios-ponte; geometria dos trilhos medida no SVG do Fritzing e conferida contra os barramentos do Half_breadboard_v2
    - HC-SR04 e TCRT5000 fora da protoboard com jumpers femea-macho (modelo, desenho, guia e .fzz com os fios); divisor na metade de baixo da P1 (R1 22C-26C, R2 26D-29D, R3 29A -> trilho -; no = coluna 26; W3 26E -> 5A)
    - LCD na fileira J da P2, cada pino de alimentacao com jumper curto ate o trilho; R4/R5 atravessam o canal
    - potenciometro removido: netlist sem P1/POT_WIPER; firmware DEFAU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
    [MotionPet_estagioB.fzz, MotionPet_estagioC.fzz, MotionPet_estagioD.fzz, MotionPet_estagioE.fzz, fios_estagioB.csv, fios_estagioC.csv, fios_estagioD.csv, fios_estagioE.csv]
2026-10-30 fix(cad): pinagem da ESP32 corrigida (DevKitC: 5V e CLK junto da USB)
    - o modelo punha o pino 1 (3V3/GND) junto da USB; na DevKitC o 5V e o CLK ficam junto da USB. Com a USB-C na ponta da coluna 1: 5V em 1J, 3V3 em 19J, IO34 em 15J, IO5 em 10A
    - refeitos os furos ligados a ESP32 (W1 1J, W2 13A, W3 26E->15J, TRIG 10A, TCRT 19J/6J/14J, sinais do LCD 12A/11A/14A/17A/18A/9J); validacao e testes atualizados
    Claude-Session: https://claude.ai/code/session_01JgeQuGUfuHMxjHTnspnTXQ
    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
    [MotionPet_estagioA.fzz, MotionPet_estagioB.fzz, MotionPet_estagioC.fzz, MotionPet_estagioD.fzz, MotionPet_estagioE.fzz, fios_estagioB.csv, fios_estagioC.csv, fios_estagioD.csv]
2026-10-30 chore(bancada): gravar_firmware.bat para regravar o firmware do MotionPet via PlatformIO (COM3)
    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
2026-10-30 chore(bancada): gravar_firmware.bat com passo manual de modo de gravacao (BOOT + EN)
    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
2026-11-11 feat(motionpet): montagem final sem LCD e interface Piu-piu no notebook
    Checkpoint do trabalho de bancada de 05 a 10/11, antes de migrar para o T3.
    - Bancada: ESP32 + HC-SR04 (5 V, ECHO pelo divisor 1k+1k+300 ohm no GPIO34)
    + TCRT5000 (3,3 V, DO no GPIO35) validados juntos na COM3. Ligacoes reais
    em docs/bench_verified_wiring.md e hardware/wokwi/montagem_atual/.
    - LCD 2004 I2C fora da montagem: ilegivel em 3,3 V e, em 5 V, depende de um
    conversor de nivel que nao temos. HAL I2C e animacao ficam no firmware.
    - terminal.bench.guide: guia de montagem com teste por componente; leitura
    serial passa a juntar fragmentos ate completar cada mensagem.
    - terminal.web: interface no notebook (po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
    [MotionPet_estagioA.fzz, MotionPet_estagioB.fzz, MotionPet_estagioC.fzz, MotionPet_estagioD.fzz, MotionPet_estagioE.fzz, fios_estagioB.csv, fios_estagioC.csv, fios_estagioD.csv]
2026-11-11 docs: AGENTS.md com comandos confirmados, ligacoes da bancada e regras para agentes
2026-11-11 docs(hardware): registro da montagem sem LCD e limpeza do legado do LCD
    - diagram.json passa a ser a montagem vigente sem LCD; antigo preservado em diagram_historico_com_lcd.json
    - netlist vigente motionpet_atual_sem_lcd.json; motionpet_final_i2c.json fica como perfil historico
    - bench_verified_wiring.md descreve a bancada de 2026-11-10
    - README e docs antigos com aviso de historico; READMEs de legado em teste-lcd e teste-i2c-scan
2026-11-11 fix(terminal): validacao de payload, ACK/ERROR por seq e fila de acoes limitada
    - valida a mensagem inteira antes de qualquer efeito; payload invalido e descartado e contado
    - liga cada comando ao ACK/ERROR pelo seq, com timeout de 5 s
    - LOAD/RESET reiniciam partida e recordes a partir do pet confirmado
    - listener processa cada sensor_frame em ordem (toques do IR nao se perdem)
    - fila de acoes limitada a 8, com ticket por acao; acao vencida nunca executa
    - distance_cm nao finito e rejeitado
    [protocol.py, test_backend_review_fixes.py]
2026-11-12 feat: MotionLab, pipeline de ML/MLOps e envio Wi-Fi/MQTT da ESP32
    - Interface MotionLab (Motion Control, Canvas, Air Music, Air Slides,
    Motion Intelligence); pet Piu-piu movido para /legacy/.
    - terminal/motionlab: sinais, reconhecedores, perfis e acoes.
    - ml/: experimento reprodutivel, API de inferencia, ingestao MQTT/IoT.
    - ops/: stack MLOps (MQTT, Airflow, MLflow) e broker LAN com TLS/ACL.
    - firmware: Wi-Fi STA + MQTT QoS 1/TLS opcional, testado na bancada.
    - docs: README com grupo 5, papeis, fotos e capturas; checkpoint.
    [compose.yaml]
2026-11-12 docs: figuras de arquitetura e circuito usadas no relatorio e no site
2026-11-12 docs: alinha README e checkpoint ao relatorio do Check Point
    - adiciona o link do Google Sites ao README e corrige o nome de um integrante
    - documenta limites do firmware: LCD residual e TLS/IoT dependente de configuracao local
    - marca a pendencia do Google Sites como resolvida em docs/publicacao.md
    - registra no checkpoint o que mudou desde 11/11 (MQTT, repo publico, commits, testes, figuras)
    - remove link quebrado do enunciado e links file:/// com caminho local
    - explica a peca substituta do TCRT5000 no Wokwi
2026-11-12 fix: testes em clone limpo e ajustes do firmware apos revisao
    Testes
    - test_firmware_cycle3: o helper treinava o modelo com argumentos trocados
    (split no lugar das janelas, configs fora de ordem) e quebrava sem data/models/
    - test_guide_ui.cjs: aceita CRLF no guia (core.autocrlf=true no Windows)
    - README: a suite completa exige requirements-mlops.lock (cryptography)
    Firmware (nao compilado nesta maquina; ver docs/revisao_firmware_testes_2026-11-12.md)
    - MOTIONLAB_LCD_HW_ENABLED (padrao 0): sem init I2C, animacao de boot de ~3 s
    e escrita no barramento; o quadro virtual segue para o notebook
    - tarefa MotionIoT no nucleo 0, junto do Wi-Fi, fora da espera ativa do HC-SR04
    - setup confere m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
    [main.cpp, pinout_config.h, test_firmware_cycle3.py, test_firmware_review_fixes.py]
2026-11-12 feat: requisitos de Aprendizado de Maquina (modelos, busca, MLflow, Compose)
    Modelagem e validacao
    - KNN (com StandardScaler) e AdaBoost como candidatos de comparacao
    (--extended-models); ficam fora da selecao do modelo embarcado
    - Grid Search e Random Search por familia de modelo, com GroupKFold so no
    desenvolvimento (--search grid|random); vencedor aplicado ao treino final
    - CV registra F1 de treino por fold, diferenca treino-validacao e diagnostico
    de sobreajuste/subajuste
    MLOps
    - MLflow: experimento proprio MotionLab-<coorte>-hiperparametros, um run por
    combinacao; metricas de treino e diagnostico nos runs dos modelos
    - DAG do Airflow roda a comparacao estendida e o Grid Search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
